aidansw0/beer_fridge/README.md

# Beer Fridge
An interactive beer fridge monitoring program that interfaces with an Arduino based sensor module to display information about the current beer as well as a beer rating system. The project consists of three major components: the load cell and temperature sensor module, the kegging equipment and the GUI application. The GUI features a user idenification system that uses an RFID card scanner to idenitfy users; this allows for certain users to be flagged as 'admin' which then allows for several administrative control options.

The onboard wifi of the sensor posts data to <a href="http://dweet.io/">dweet.io</a> via an HTTP get request. On the other end this data is polled from dweet.io and displayed on the screen

The sensor module uses the <a href="https://store.ti.com/cc3200-launchxl.aspx">TI CC3200 Launchpad</a> which is essentially an Arduino with built in wifi and other peripherals. The <a href="http://energia.nu/">Energia</a> IDE is used to program the device.

The project was initially intended to be used as a coffee pot monitoring program that would use a web based application to display coffee information. However, the concept was transfered to a beer fridge instead.

Credit to <a href="https://www.linkedin.com/in/greg-powell-b3b88515/">Greg Powell</a> for the original idea.

### Setting up the Sensor
The sensor module consists of the CC3200 Launchpad as well as a <a href="https://www.sparkfun.com/products/13879">HX711 load cell amplifier</a>, a <a href="https://www.sparkfun.com/products/13878?_ga=1.196320228.931348548.1481592610">load cell combinator board</a> and four <a href="https://www.sparkfun.com/products/10245">50 kg load cells</a>. Follow the respective documentation of the latter three items for exact information on their wire connections.

Once completed the load cell unit can be connected to the launchpad (refer to <a href="http://energia.nu/wordpress/wp-content/uploads/2014/06/LaunchPads-CC3200-%E2%80%94-Pins-Maps-12-28.jpeg">this</a> document for Launchpad pins):

#### HX711 -----> Launchpad
* Vcc   -----> 3.3V   (pin 1)
* Vdd   -----> 5V     (pin 2)
* DAT   -----> pin 27
* CLK   -----> pin 28
* GND   -----> GND

DAT and CLK can be connected to any digital pins on the Launchpad but must be configured as such in the .ino file.

The library used for interfacing with the HX711 can be found <a href="https://github.com/bogde/HX711">here</a> and added to the `/libraries` folder of the Energia IDE installation folder.

Next start Energia and open the `arduino_sensor.ino` file. Near the top of the file enter your wifi credentials in the fields `char ssid[]` and `char password[]` respectively. Lastly, enter a unqiue "thing name" for your device in the field `#define THING_NAME` also near the top of the file; this is used to relay sensor data to the Java application via dweet.io.

There is also un-implemented code in this file that can be used to send notifications to a <a href="https://slack.com/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,189426831117,slack&gclid=CM2m-ZT7wNMCFQt3fgodmmIHtQ">Slack</a> chat channel, however this code may need to be heavily editied for it to work.

Connect the Launchpad to the computer via USB and short pins TCK and 2 (marked by white line in above link) to set it to programming mode then upload the .ino file.

### Setting up the Java Application
CLone this repo and open the project in your Java IDE and install the <a href="http://www.java2s.com/Code/JarDownload/java/java-json.jar.zip">java-json</a> library which is needed for parsing the JSON data from dweet.io.

Locate the file `src/backend/DweetManager.java` and change the field `DWEET_URL` declared just below the class declaration to the **SAME** "thing name" that you used when editing `arduino_sensor.ino`. Compile the program to ensure there are no errors and then export the application as a runnable `.jar` file; place the `.jar` file where ever desired but note that data files for the program will be generated at the same location.

*In it's current state the GUI for the application is not completely responsive on a 16:9 aspect ratio display.*

The GUI itself is straight forward to use and is most natural on a touch screen, however a mouse can still be used. Users are verified using a USB RFID card scanner; administrators can add beers along with other options found in the admin panel while regular users can only up-vote a single beer until an admin resets the voting. To add an admin locate the file `src/backend/KeyCardListener.java` and add the line `saveData.setAdmin("your key card id here", true);` (before exporting the `.jar` file) in the constructor below the initialization of `saveData`. See the RFID scanner setup section for info on how to find your key card ID. Once an initial admin has been set new ones can be added via the admin panel. 

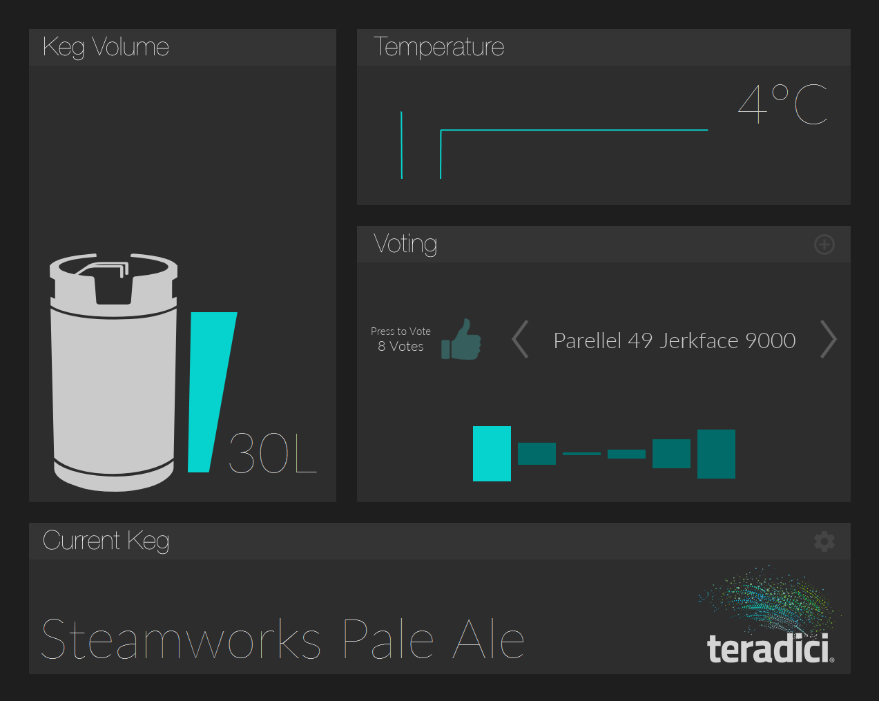
[picture p1: photos/screenshot.png]
GUI


### Setting up the RFID Scanner
The beer fridge uses a <a href="https://www.rfideas.com/products/readers/pcprox">RFIDeas pcProx card reader</a> to track and verify users however, with some modification to the source code this can be disabled to allow anyone to access the system. 

Start the pcProx <a href="https://www.rfideas.com/support/product-support/pcprox-plus">configuration utility</a> and connect the scanner to the computer. Navigate first to the `SDK` tab and ensure that the `Disable Keystrokes for SDK` field is unchecked and then move to the `Format` tab and check the fields `Send ID` and `Send ID as hexidecimal number`. Fianally, click the `Write Settings` button and wait for the program to finish. At the bottom of the window there is a green text field, give this field focus by clicking on it and scan your RFID card to ensure that it is working. Here you can also copy and paste your card ID (without the forward slash) into the `.setAdmin()` call in the Java program.

Simply plug the RFID scanner into whichever computer is being used to run the application and key cards should automatically be verified. New cards, when swiped, are automatically encrypted and saved to the local data base.

### Setting up the Scale
The four load cells can be mounted on either a metal or wooden bottom plate using two metal screws each. The mounting fixture for the load cells can be downloaded <a href="http://www.thingiverse.com/thing:2274593">here</a> and 3D printed with %50 fill; credit to Greg Powell for the design. The bottom plate should be about as wide as the beer keg.

To calibrate the scale open `arduino/scale_calibration/scale_calibration.ino` in Engergia and upload the file to the Launchpad. Open the serial monitor set the baud rate to 115200 and place a known weight on the scale. Then change the values of `#define CALIBRATION` and `#define CONVERSION_FACTOR` until the correct weight of the item is shown. See the documentation for the HX711 library linked above for more information on scale calibration. Once these two values have been determined open `arduino/arduino_sensor/arduino_sensor.ino` and enter their values into the fields `#define CALIBRATION` and `#define CONVERSION_FACTOR`. 

The top plate for the scale will simply rest freely on the load cells and can be made out of wood or metal as well (the beer keg will sit directly on top of this plate).

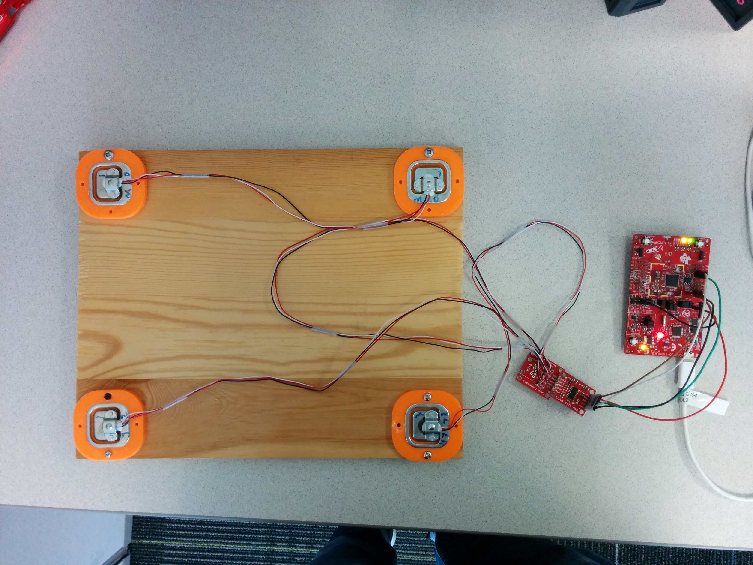
[picture p2: photos/IMG_20170427_145124.jpg]
Scale


### Bring it all Together
Use whichever beer tap, tubing and other connectors for tapping the keg desired; simply drill a whole through the fridge and feed the tubing through to attach onto the tap. 

Place the scale with the bottom and top plate in the frige and enclose the sensor module in an appropiate container (preferably one made out of a material with an <a href="http://www.infrared-thermography.com/material-1.htm">emissivity</a> value > 0.7). Plug in the sensor module and place the keg onto the top plate of the scale. 

Finally, put the sensor module somewhere inside the fridge and set the program to a new keg with the correct size (30/50 L) using the admin panel; the sensor only reads the change in weight of the keg and thus does not need to be tared during the kegging process. If the temperature sensor seems to be reading a slightly different value than expected or when compared to another sensor then refer to <a href="https://cdn.sparkfun.com/datasheets/Sensors/Temp/sbou107.pdf">this</a> document for information on exact placement of the sensor.

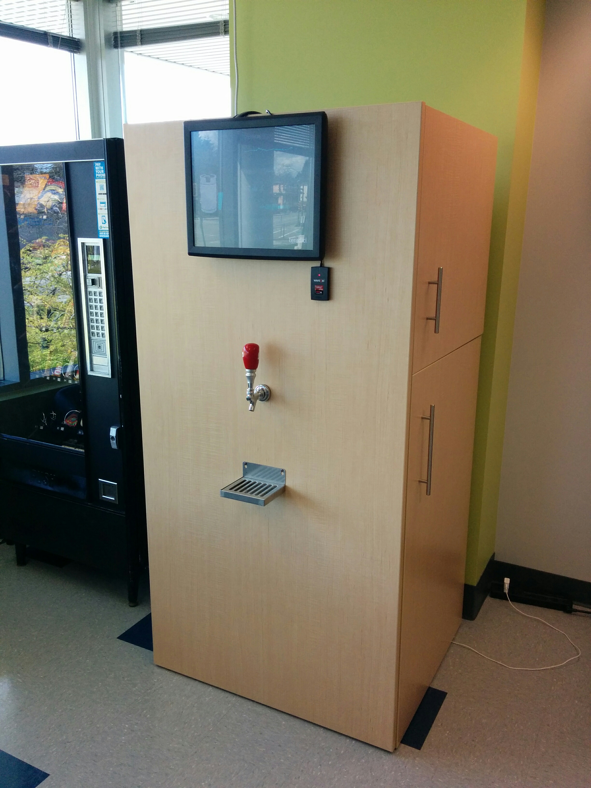
[picture p3: photos/IMG_20170428_150106.jpg]
Outside


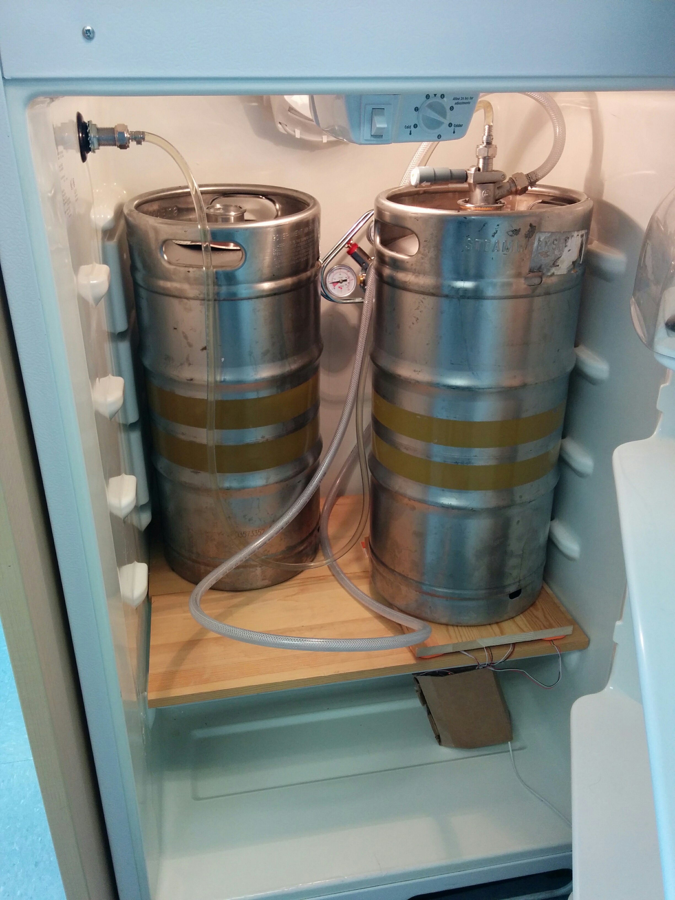
[picture p4: photos/IMG_20170428_150119.jpg]
Inside


*Project developed by <a href="https://www.linkedin.com/in/aidan-wilson-5b973b137/">Aidan Wilson</a> and <a href="https://www.linkedin.com/in/rchen93/">Richard Chen</a> with help from <a href="https://www.linkedin.com/in/greg-powell-b3b88515/">Greg Powell</a>.*
