aidansw0/beer_fridge/photos/IMG_20170427_160940.jpg

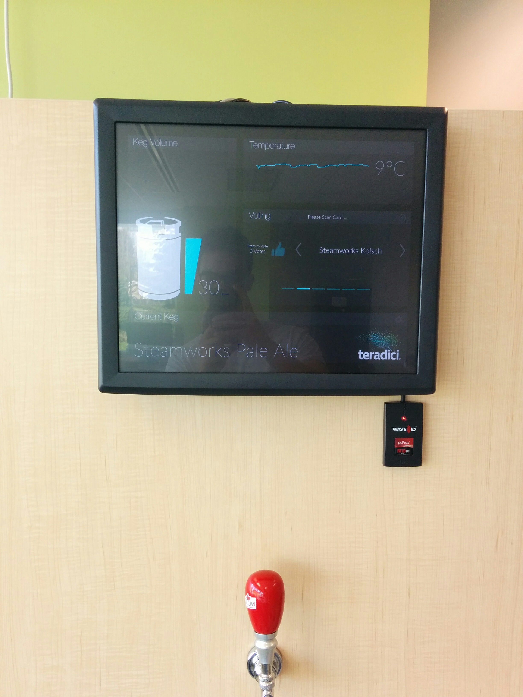
photos/IMG_20170427_160940.jpg
