aidansw0/beer_fridge/photos/IMG_20170428_140808.jpg

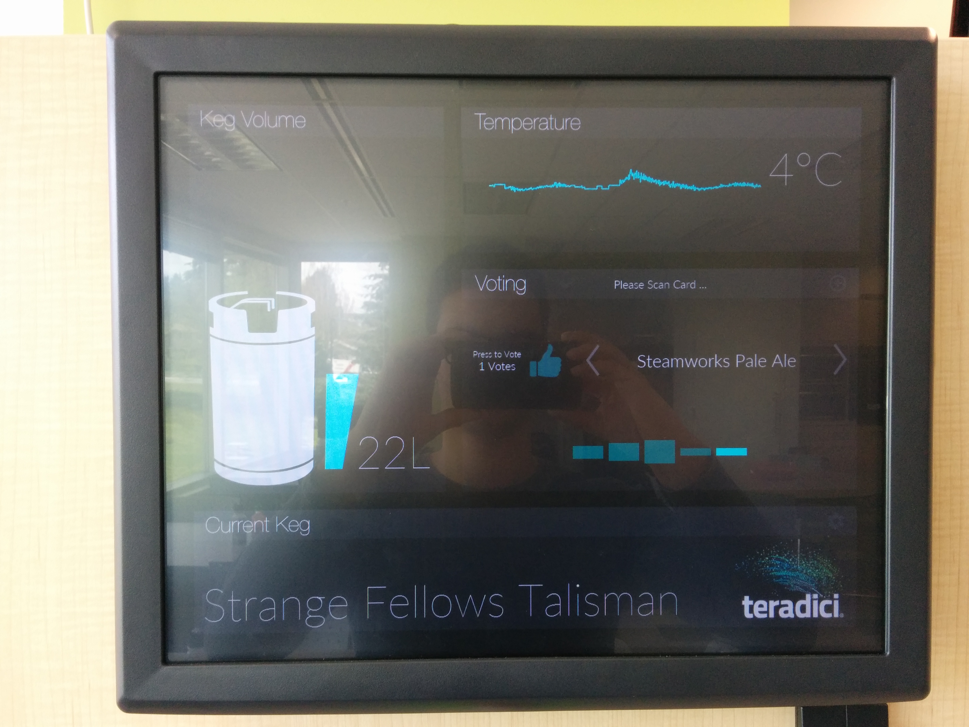
photos/IMG_20170428_140808.jpg
