aidansw0/beer_fridge/src/img/keg.png

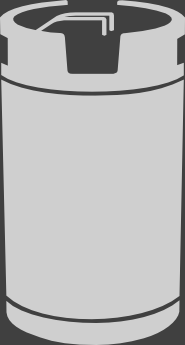
src/img/keg.png
