aidansw0/beer_fridge/arduino/arduino_sensor/arduino_sensor.ino

/*
  This file tracks the amount of beer left in the keg
  and the temperature of the fridge.
*/
#include <Energia.h>
#include <Wire.h>
#include <HX711.h>
#include <Adafruit_TMP006.h>
#include <WiFi.h>
#include <WiFiClient.h>

//#define DEBUG_HTTP
#define DEBUG_SCALE
#define UPDATE_DWEET

// This is for the scale HX711
#define DOUT          27 
#define CLK           28
#define CALIBRATION  -2000 // this number comes from scale calibration
#define CONVERSION_FACTOR    12.1 // conversion factor to get kg from scale
#define WINDOW_SIZE   20 // number of readings taken to calculate average weight

// Your network SSID and password
char ssid[] =         "";
char password[] =     "";

// HTTP Request
#define HTTP_PORT             80  
#define THING_NAME            ""
#define REQUEST_INTERVAL      2000    // dweet update interval in ms
#define WIFI_CHECK_INTERVAL   60000   // check wifi interval in ms

WiFiClient client;
unsigned long last_update = 0;
unsigned long last_wifi_check = 0;
// unused variables for slack notifications
char dweet_server[] = "dweet.io";
char thingspeak_server[] = "api.thingspeak.com";
char slack_server[] = "hooks.slack.com";
int update_request = 0;
String received_data_string;

// Create HX711 object by passing the pin used on the launchpad
HX711 scale(DOUT, CLK);

// Create temp senseor object by passing i2c address]
Adafruit_TMP006 tmp006(0x41);

float data[WINDOW_SIZE]; // array of weight readings for averaging
int average_weight = 0;

void setup() {
  //Initialize serial and wait for port to open:
  Serial.begin(115200);

  // Scale initialization
  scale.set_scale(CALIBRATION);
  // scale doesnt tare and instead the Java app handles taring
  //scale.tare();

  connectWifi();

  last_wifi_check = millis();
  last_update = millis();

  //Initialize button interrupt for taring
  pinMode(PUSH1, INPUT_PULLUP);
  attachInterrupt(PUSH1, scale_tare, FALLING);

  // Start temperature sensor
  if (!tmp006.begin()) {
    Serial.println("TMP006 sensor not found!");
  } else {
    Serial.println("Starting temperature sensor");
  }
}

void loop() {
  float weight = scale.get_units(10) / CONVERSION_FACTOR;
  float temp = getTemperature();
#ifdef DEBUG_SCALE
  Serial.print("weight: ");
  Serial.print(weight);
  Serial.print(" Temp: ");
  Serial.println(temp);
#endif

  enqueue_data(weight);
  average_weight = mean();

#ifdef UPDATE_DWEET
  if (millis() - last_update > REQUEST_INTERVAL) {
    postToDweet(average_weight, temp);
    read_received_data();
    check_received_data();
    last_update = millis();
  }
#endif

  // check if wifi is still connected
  if (millis() - last_wifi_check > WIFI_CHECK_INTERVAL) {
    if (WiFi.status() != WL_CONNECTED) {
      Serial.println("Wifi disconnecting, attempting to reconnect...");
      connectWifi();
      last_wifi_check = millis();
    }
  }

  delay(500);
}



float getTemperature() {
  float temp = tmp006.readObjTempC() + 273.15; // convert to kelvins
  return temp;
}



void connectWifi() {
  Serial.print("Attempting to connect to Network named: ");
  Serial.println(ssid);

  // Connect to WPA/WPA2 network. Change this line if using open or WEP network:
  WiFi.begin(ssid, password);
  while ( WiFi.status() != WL_CONNECTED) {
    // print dots while we wait to connect
    Serial.print(".");
    delay(300);
  }

  Serial.println("\nYou're connected to the network");
  Serial.println("Waiting for an ip address");
  while (WiFi.localIP() == INADDR_NONE) {
    // print dots while we wait for an ip addresss
    Serial.print(".");
    delay(300);
  }

  Serial.println("\nIP Address obtained");
  // you're connected now, so print out the status
  printCurrentNet();
  printWifiData();
}



void printWifiData() {
  // print your WiFi IP address:
  IPAddress ip = WiFi.localIP();
  Serial.print("IP Address: ");
  Serial.println(ip);
  Serial.println(ip);

  // print your MAC address:
  byte mac[6];
  WiFi.macAddress(mac);
  Serial.print("MAC address: ");
  Serial.print(mac[5], HEX);
  Serial.print(":");
  Serial.print(mac[4], HEX);
  Serial.print(":");
  Serial.print(mac[3], HEX);
  Serial.print(":");
  Serial.print(mac[2], HEX);
  Serial.print(":");
  Serial.print(mac[1], HEX);
  Serial.print(":");
  Serial.println(mac[0], HEX);
}



void printCurrentNet() {
  // print the SSID of the network you're attached to:
  Serial.print("SSID: ");
  Serial.println(WiFi.SSID());

  // print the MAC address of the router you're attached to:
  byte bssid[6];
  WiFi.BSSID(bssid);
  Serial.print("BSSID: ");
  Serial.print(bssid[5], HEX);
  Serial.print(":");
  Serial.print(bssid[4], HEX);
  Serial.print(":");
  Serial.print(bssid[3], HEX);
  Serial.print(":");
  Serial.print(bssid[2], HEX);
  Serial.print(":");
  Serial.print(bssid[1], HEX);
  Serial.print(":");
  Serial.println(bssid[0], HEX);

  // print the received signal strength:
  long rssi = WiFi.RSSI();
  Serial.print("signal strength (RSSI):");
  Serial.println(rssi);

  // print the encryption type:
  byte encryption = WiFi.encryptionType();
  Serial.print("Encryption Type:");
  Serial.println(encryption, HEX);
  Serial.println();
}



void postToDweet(int weight, float temp) {
  int age_in_min;

  if (weight < 0) {
    weight = 0;
  }

  if (client.connect(dweet_server, HTTP_PORT)) {
#ifdef DEBUG_HTTP
    Serial.print("Sending: ");
    Serial.println(weight);
    Serial.println(temp);
#endif

    client.print(F("GET /dweet/for/"));
    client.print(THING_NAME);
    client.print(F("?weight="));
    client.print(weight);
    client.print(F("&temp="));
    client.print(temp, 2);
    client.println(F(" HTTP/1.1"));

    client.println(F("Host: dweet.io"));
    client.println(F("Connection: close"));
    client.println(F(""));
  }
}



bool postToSlack(int retries) {
  for (int i = 0; i < retries; i++) {
    if (client.connect(thingspeak_server, HTTP_PORT)) {
      Serial.println("Posting to slack");
      client.print(F("GET /apps/thinghttp/send_request?api_key=F901JQEU48SBZ7VL"));
      client.println(F(" HTTP/1.1"));

      client.println(F("Host: api.thingspeak.com"));
      client.println(F("Connection: close"));
      client.println(F(""));

      return true;
    }
    else {
      Serial.print("Posting failed.. attempt #");
      Serial.println(i + 1);
      read_received_data();
    }
  }
  return false;
}



bool postMessageToSlack(String msg) {
  const char* host = "hooks.slack.com";
  String slack_username = "coffeepot";
  String slack_hook_url = "/services/T4VQS0ZMM/B4V6J3WKU/SCP8SnUAQagbEmlMTGui1A8p";

  Serial.print("Connecting to ");
  Serial.println(host);

  // Use WiFiClient class to create TCP connections
  //WiFiClientSecure client;
  const int httpsPort = 443;
  if (!client.connect(host, httpsPort)) {
    Serial.println("Connection failed :-(");
    return false;
  }

  // We now create a URI for the request

  Serial.print("Posting to URL: ");
  Serial.println(slack_hook_url);

  String postData = "payload={\"link_names\": 1, \"username\": \"" +
                    slack_username + "\", \"text\": \"" + msg + "\"}";

  // This will send the request to the server
  client.print(String("POST ") + slack_hook_url + " HTTP/1.1\r\n" +
               "Host: " + host + "\r\n" +
               "Content-Type: application/x-www-form-urlencoded\r\n" +
               "Connection: close" + "\r\n" +
               "Content-Length:" + postData.length() + "\r\n" +
               "\r\n" + postData);
  Serial.println("Request sent");
  String line = client.readStringUntil('\n');
  Serial.print("Response code was: ");
  Serial.println(line);
  if (line.startsWith("HTTP/1.1 200 OK")) {
    return true;
  } else {
    return false;
  }
}



boolean read_received_data() {
  boolean valid_data = false;
  /* if there is incoming data from the connection
     then read it */
  if ( client.available() > 0 ) {
    /* copy each character into the data string */
    do {
      char c = client.read();
      received_data_string += c;
    } while (client.available());
    /* valid data received */
    valid_data = true;
  }

  return valid_data;
}



void check_received_data() {
  int string_index;
  int data_length;

  /* get data length */
  data_length = received_data_string.length();
  /* check if the message starts as expected */
  if (received_data_string.startsWith("HTTP/1.1 200 OK")) {

    /* find "this:" field */
    string_index = received_data_string.indexOf("this");
    /* if the previous field is whithn the data string */
    if (string_index < data_length) {
      /* check if get request has succeeded */
#ifdef DEBUG_HTTP
      if (received_data_string.startsWith("succeeded", string_index + 7)) {
        Serial.println("Request acknowledged");
      }
      else {
        Serial.println("Request not acknowledged");
      }
#endif
    }
  }

  /* clean received data string */
  received_data_string.remove(0);
}



void scale_tare () {
  Serial.println("Taring!");
  scale.tare();
}



void enqueue_data(float new_data) {
  static int pointer = 0;
  data[pointer] = new_data;

  if (pointer < WINDOW_SIZE - 1) {
    pointer++;
  }
  else {
    pointer = 0;
  }
}



float mean() {
  float sum = 0.0;

  for (int i = 0; i < WINDOW_SIZE; i++) {
    sum += data[i];
  }

  return sum / WINDOW_SIZE;
}
