aidansw0/beer_fridge/(commit log)

2017-04-11 prototyping buttons
2017-04-12 Added all frames, window resizable
2017-04-12 more on buttons
2017-04-12 Temperature graph now working but very messy code - TODO: Remove randomly generated temperature data - TODO: Move to separate class - FIXED: Imported Google fonts to fix compatibility issues
    [Main.java]
2017-04-12 Added footer frame and tera logo
2017-04-12 Moved temperature chart to separate class
2017-04-12 added arduino source
2017-04-12 more arduino
2017-04-13 Linked button to ButtonManager class
2017-04-14 added temperature to arduino code for dweets
2017-04-14 Refactored into ButtonManager into VoteManager - Added comments for class and methods
2017-04-18 Press temp label to switch between Kelvin and Celsius
2017-04-18 Pop up keyboard added, will try to replace footer with keyboard instead
    [Main.java]
2017-04-18 Moved virtual keyboard to footer frame - Need to add button for adding beer and text field - Clean up code later, lots of random globals
2017-04-18 Keyboard replaces footer and new items can now be added
    [Main.java]
2017-04-19 cleaning arduino code
2017-04-19 Handles exception with empty file - will now redraw new rectangles as they are added - fixed issue with scrolling when less than 10 items are displayed
    [Main.java]
2017-04-21 Added timer to expire keycard and disable buttons
2017-04-21 Allowed new cards to be added when vote is registered, fixed bug with upper/lower case key ids
    [Main.java]
2017-04-24 Added more resolution to temperature chart
2017-04-24 Autoscale x-axis for temperature chart to show more data
2017-04-25 Fixed bug where escape and enter were not registering, needed to request focus for text field
    [Main.java]
2017-04-25 Fixed timeout issue - timers need to be cancelled when access is consumed - also needs to be cancelled when slash is pressed
    [Main.java]
2017-04-25 Two bugs to fix: - when timer expires, keyboard stops working - DataManager gets initialized before kegMeter so get() throws exceptions
    [Main.java]
2017-04-25 switched temp sensor to obj temp for better readings
2017-04-25 fixed typpos from last commit
    [arduino_sensor.ino]
2017-04-25 added periodic saving of data, should be thread safe, not fully tested
2017-04-26 Added new methods in VoteManager to manage and update all displays - Admin panel created with button placeholders
2017-04-26 trying to calibrate scale still
2017-04-26 reset vote and delete buttons working
    [Main.java]
2017-04-26 set current keg button done
2017-04-26 Added button for taring to new keg
2017-04-27 Added taring, still need to store current keg and tare value to file
2017-04-27 implemented read/write current beer info in saveData
2017-04-27 reading/writing current keg now being used in Main
2017-04-28 Added buttons for manually adjusting current keg level
2017-04-28 removed taring from arduino
2017-05-01 Cleaned up voting and footer frames
2017-05-08 Changed likes display and beer display to string binding
    [Main.java]
